dankirkham/HandheldGame/README.md

# HandheldGame
DOT MATRIX WITHOUT STEREO SOUND

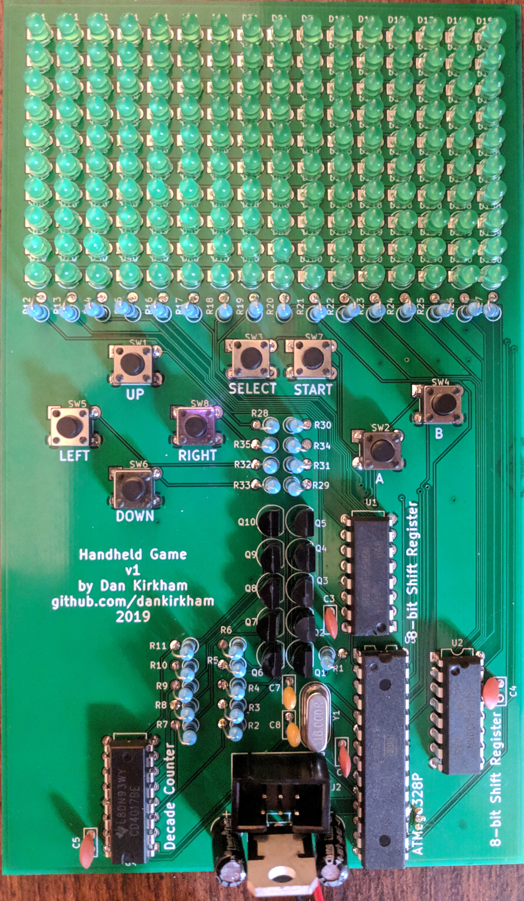
[picture p1: pics/assembly.jpg]
HandheldGame Assembly
