dankirkham/HandheldGame/enclosure/top.stl

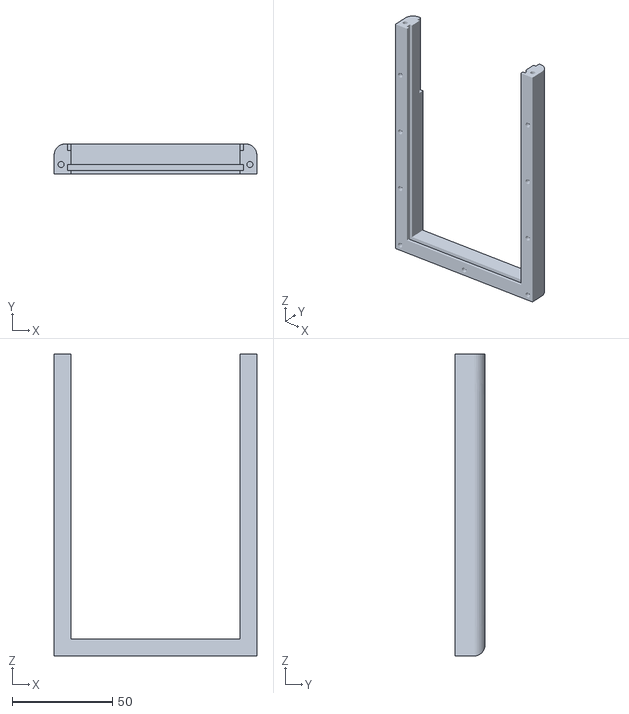
[picture p2: CAD file, 2020-03-05]
enclosure/top.stl
101.1 x 15.0 x 150.6
