dankirkham/HandheldGame/enclosure/bottom.stl

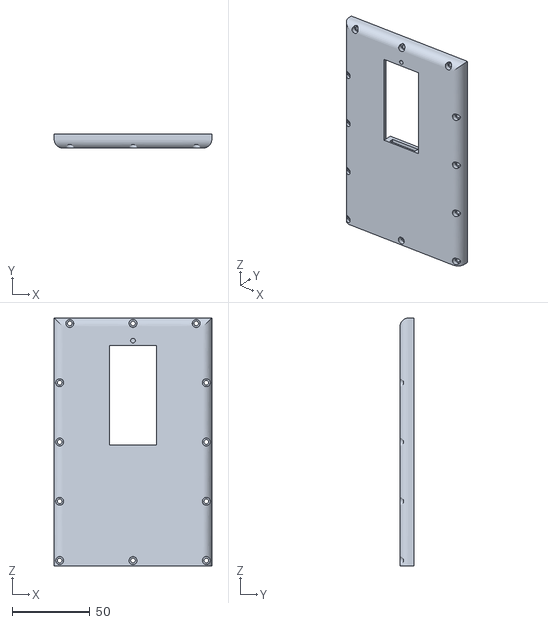
[picture p3: CAD file, 2020-03-05]
enclosure/bottom.stl
101.1 x 9.00 x 159.1
