dankirkham/HandheldGame/enclosure/top_base.stl

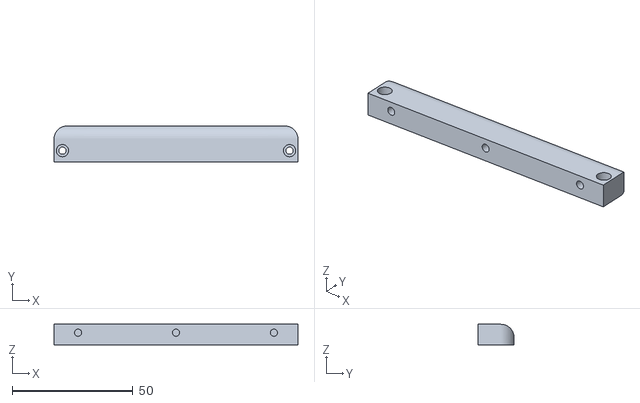
[picture p4: CAD file, 2020-03-05]
enclosure/top_base.stl
101.1 x 15.0 x 8.50
