dankirkham/HandheldGame/enclosure/battery_door.stl

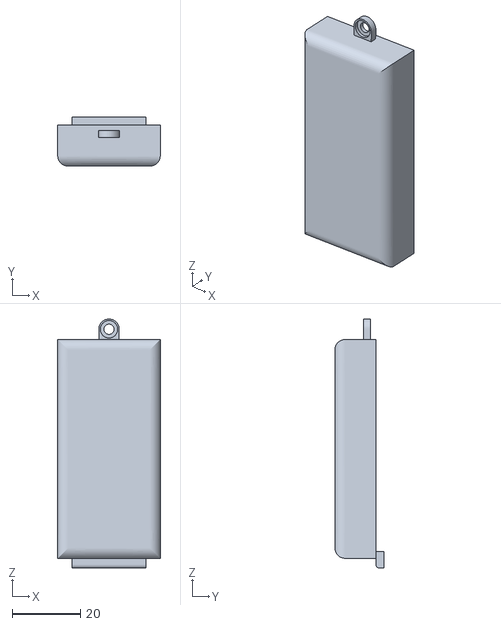
[picture p5: CAD file, 2020-03-05]
enclosure/battery_door.stl
30.0 x 14.4 x 72.8
