dankirkham/HandheldGame/hardware/HandheldGame-v1/outputs/pdf/HandheldGame-schematic.pdf

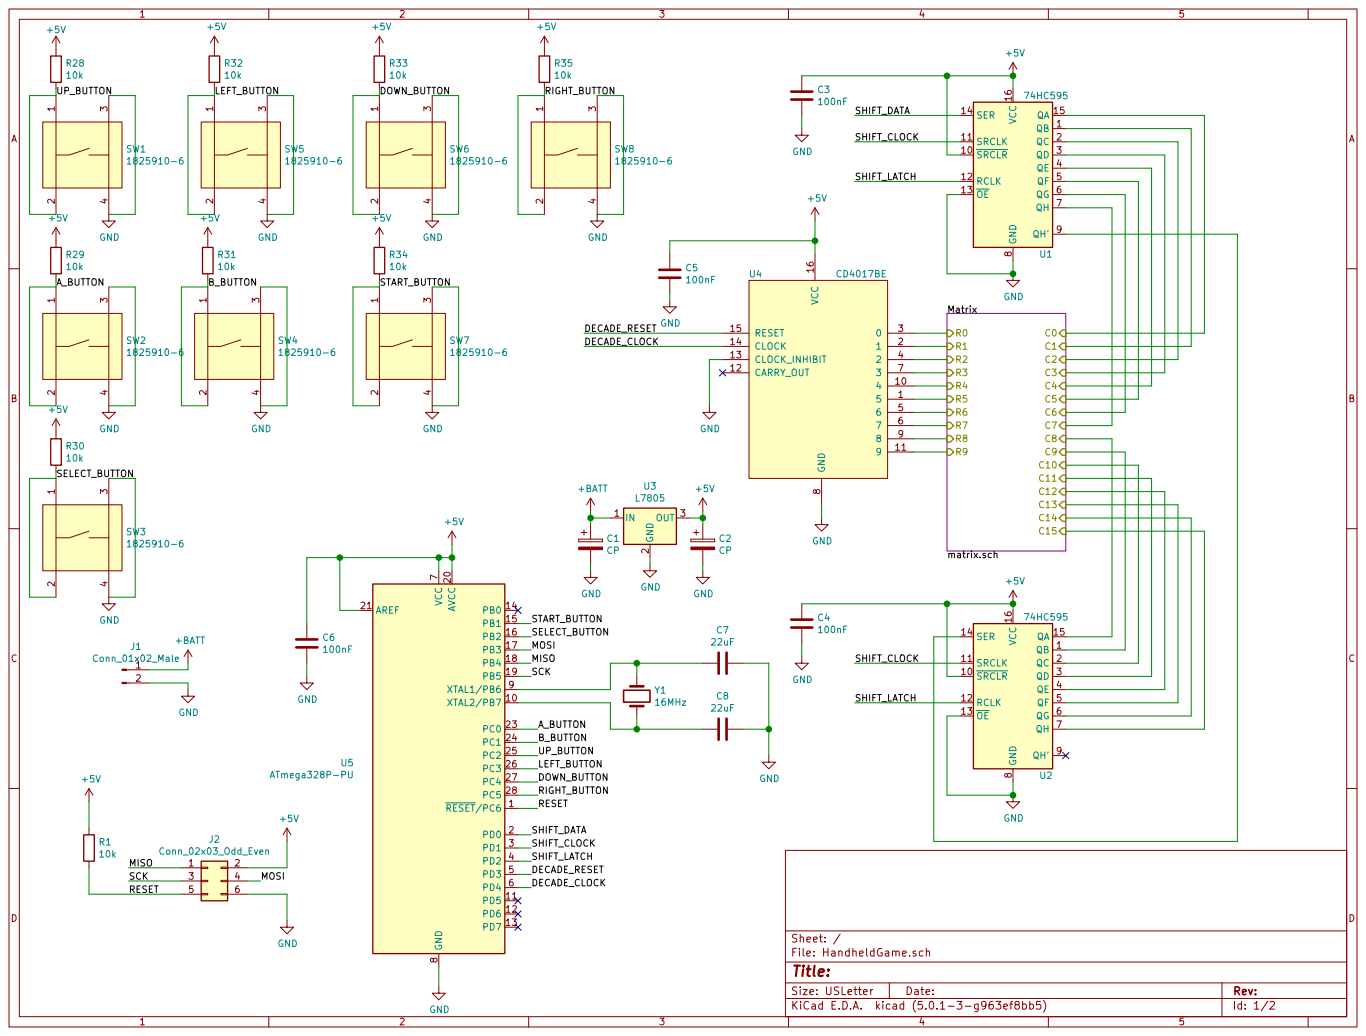
[picture p13: page 1]

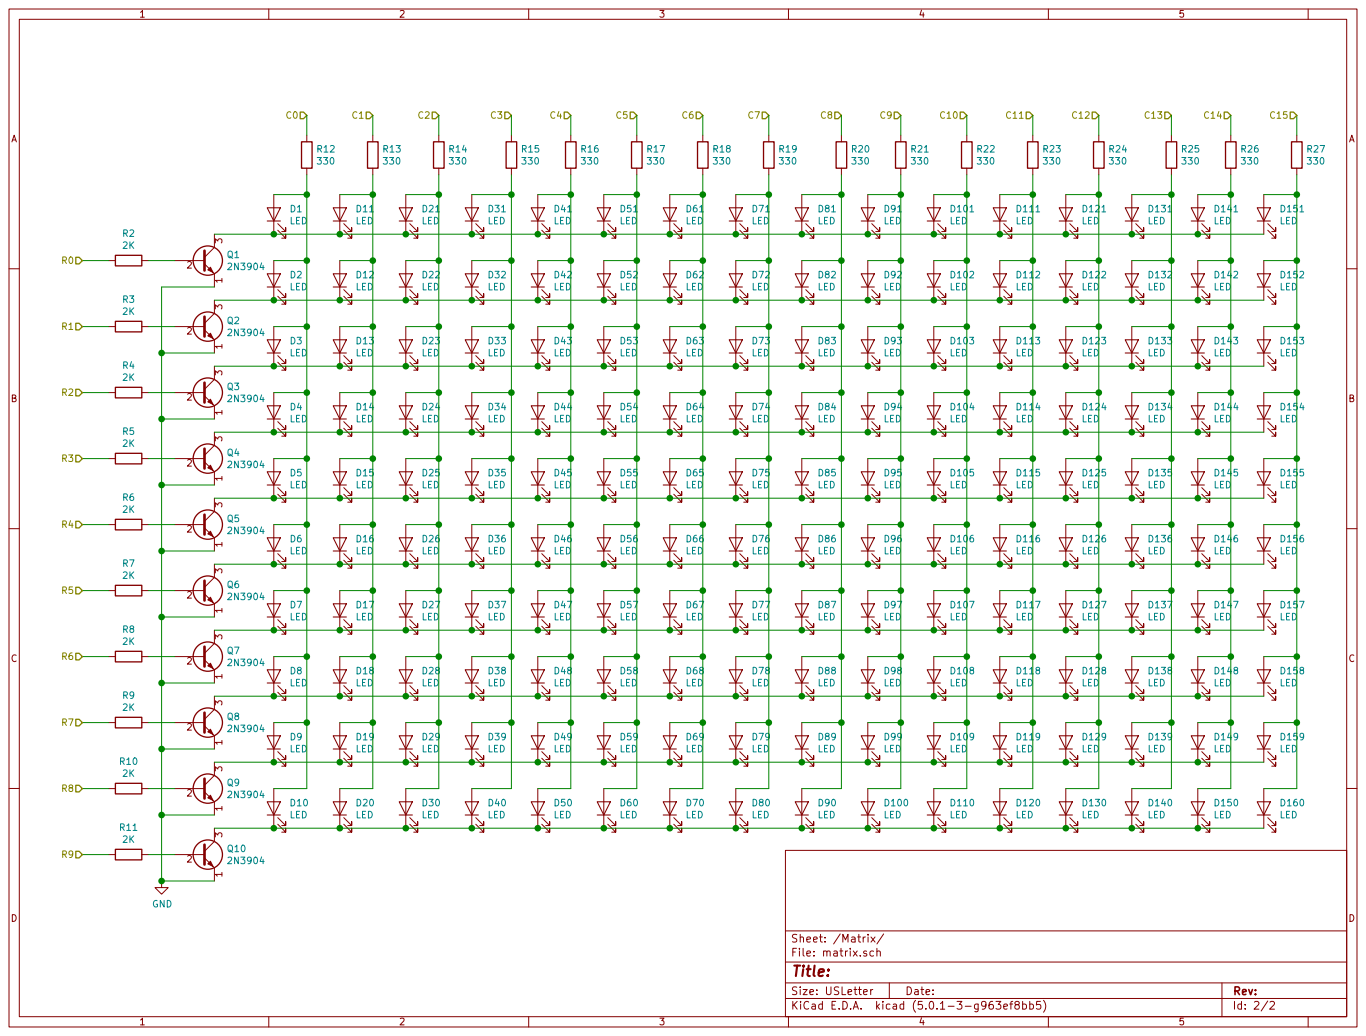
[picture p14: page 2]

Id: 2/2 Title: File: matrix.sch Sheet: /Matrix/
