dankirkham/HandheldGame/hardware/HandheldGame-v1/HandheldGame.kicad_pcb

## KiCad design hardware/HandheldGame-v1/HandheldGame.kicad_pcb (2019-03-29)

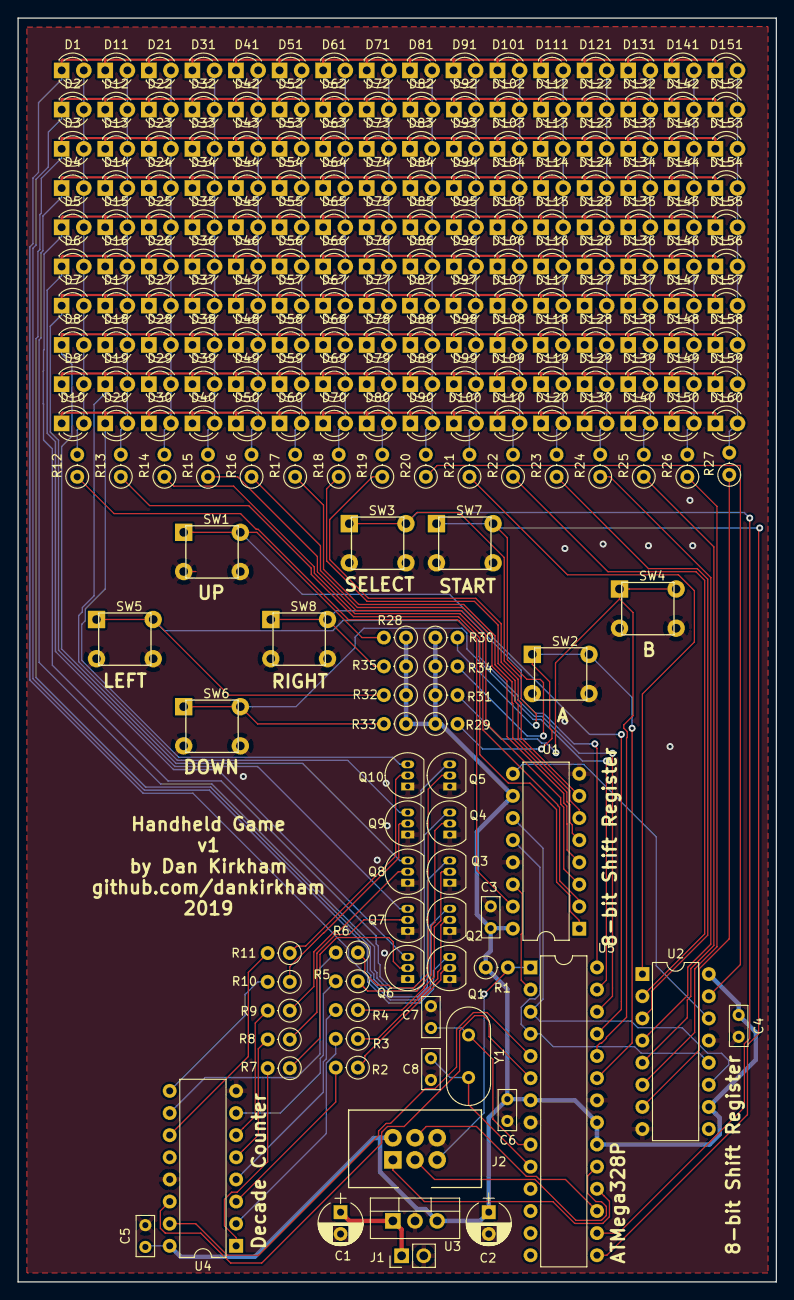
[picture p15: board HandheldGame.kicad_pcb from above]

Board: 2 copper layers, 87.0 x 145.0 mm, 229 parts (0 on the bottom side), 85 nets.

Parts:
C1, C2: CP; CP_Radial_D5.0mm_P2.50mm
C3, C4, C5, C6: 100nF; C_Rect_L4.6mm_W2.0mm_P2.50mm_MKS02_FKP02
C7, C8: 22uF; C_Rect_L4.6mm_W2.0mm_P2.50mm_MKS02_FKP02
D1, D2, D3, D4, D5, D6, D7, D8, D9, D10, D11, D12, D13, D14, D15, D16, D17, D18, D19, D20, D21, D22, D23, D24, D25, D26, D27, D28, D29, D30, D31, D32, D33, D34, D35, D36, D37, D38, D39, D40, D41, D42, D43, D44, D45, D46, D47, D48, D49, D50, D51, D52, D53, D54, D55, D56, D57, D58, D59, D60, D61, D62, D63, D64, D65, D66, D67, D68, D69, D70, D71, D72, D73, D74, D75, D76, D77, D78, D79, D80, D81, D82, D83, D84, D85, D86, D87, D88, D89, D90, D91, D92, D93, D94, D95, D96, D97, D98, D99, D100, D101, D102, D103, D104, D105, D106, D107, D108, D109, D110, D111, D112, D113, D114, D115, D116, D117, D118, D119, D120, D121, D122, D123, D124, D125, D126, D127, D128, D129, D130, D131, D132, D133, D134, D135, D136, D137, D138, D139, D140, D141, D142, D143, D144, D145, D146, D147, D148, D149, D150, D151, D152, D153, D154, D155, D156, D157, D158, D159, D160: LED; LED_D3.0mm
J1: Conn_01x02_Male; Pin_Header_Straight_1x02_Pitch2.54mm
J2: Conn_02x03_Odd_Even; ISP_Header
Q1, Q2, Q3, Q4, Q5, Q6, Q7, Q8, Q9, Q10: 2N3904; TO-92_Inline_Narrow_Oval
R1, R28, R29, R30, R31, R32, R33, R34, R35: 10k; R_Axial_DIN0207_L6.3mm_D2.5mm_P2.54mm_Vertical
R2, R3, R4, R5, R6, R7, R8, R9, R10, R11: 2K; R_Axial_DIN0207_L6.3mm_D2.5mm_P2.54mm_Vertical
R12, R13, R14, R15, R16, R17, R18, R19, R20, R21, R22, R23, R24, R25, R26, R27: 330; R_Axial_DIN0207_L6.3mm_D2.5mm_P2.54mm_Vertical
SW1, SW2, SW3, SW4, SW5, SW6, SW7, SW8: 1825910-6
U1, U2: 74HC595; DIP-16_W7.62mm
U3: L7805; TO-220-3_Vertical
U4: CD4017BE; DIP-16_W7.62mm
U5: ATmega328P-PU; DIP-28_W7.62mm
Y1: 16MHz; Crystal_HC49-U_Vertical

Connections:
+5V: C2.1, C3.1, C4.1, C5.1, C6.1, J2.2, R1.1, R28.1, R29.1, R30.1, R31.1, R32.1, R33.1, R34.1, R35.1, U1.10, U1.16, U2.10, U2.16, U3.3, U4.16, U5.7, U5.20, U5.21
+BATT: C1.1, J1.1, U3.1
/A_BUTTON: R29.2, SW2.1, SW2.2, U5.23
/B_BUTTON: R31.2, SW4.1, SW4.2, U5.24
/DECADE_CLOCK: U4.14, U5.6
/DECADE_RESET: U4.15, U5.5
/DOWN_BUTTON: R33.2, SW6.1, SW6.2, U5.27
/LEFT_BUTTON: R32.2, SW5.1, SW5.2, U5.26
/MISO: J2.1, U5.18
/MOSI: J2.4, U5.17
/Matrix/C0: R12.1, U1.15
/Matrix/C1: R13.1, U1.1
/Matrix/C2: R14.1, U1.2
/Matrix/C3: R15.1, U1.3
/Matrix/C4: R16.1, U1.4
/Matrix/C5: R17.1, U1.5
/Matrix/C6: R18.1, U1.6
/Matrix/C7: R19.1, U1.7
/Matrix/C8: R20.1, U2.15
/Matrix/C9: R21.1, U2.1
/Matrix/C10: R22.1, U2.2
/Matrix/C11: R23.1, U2.3
/Matrix/C12: R24.1, U2.4
/Matrix/C13: R25.1, U2.5
/Matrix/C14: R26.1, U2.6
/Matrix/C15: R27.1, U2.7
/Matrix/R0: R2.2, U4.3
/Matrix/R1: R3.2, U4.2
/Matrix/R2: R4.2, U4.4
/Matrix/R3: R5.2, U4.7
/Matrix/R4: R6.2, U4.10
/Matrix/R5: R7.2, U4.1
/Matrix/R6: R8.2, U4.5
/Matrix/R7: R9.2, U4.6
/Matrix/R8: R10.2, U4.9
/Matrix/R9: R11.2, U4.11
/RESET: J2.5, R1.2, U5.1
/RIGHT_BUTTON: R35.2, SW8.1, SW8.2, U5.28
/SCK: J2.3, U5.19
/SELECT_BUTTON: R30.2, SW3.1, SW3.2, U5.16
/SHIFT_CLOCK: U1.11, U2.11, U5.3
/SHIFT_DATA: U1.14, U5.2
/SHIFT_LATCH: U1.12, U2.12, U5.4
/START_BUTTON: R34.2, SW7.1, SW7.2, U5.15
/UP_BUTTON: R28.2, SW1.1, SW1.2, U5.25
GND: C1.2, C2.2, C3.2, C4.2, C5.2, C6.2, C7.1, C8.1, J1.2, J2.6, Q1.1, Q2.1, Q3.1, Q4.1, Q5.1, Q6.1, Q7.1, Q8.1, Q9.1, Q10.1, SW1.3, SW1.4, SW2.3, SW2.4, SW3.3, SW3.4, SW4.3, SW4.4, SW5.3, SW5.4, SW6.3, SW6.4, SW7.3, SW7.4, SW8.3, SW8.4, U1.8, U1.13, U2.8, U2.13, U3.2, U4.8, U4.13, U5.8, U5.22
unnamed: C7.2, U5.9, Y1.1
unnamed: C8.2, U5.10, Y1.2
unnamed: D1.1, D11.1, D21.1, D31.1, D41.1, D51.1, D61.1, D71.1, D81.1, D91.1, D101.1, D111.1, D121.1, D131.1, D141.1, D151.1, Q1.3
unnamed: D1.2, D2.2, D3.2, D4.2, D5.2, D6.2, D7.2, D8.2, D9.2, D10.2, R12.2
unnamed: D10.1, D20.1, D30.1, D40.1, D50.1, D60.1, D70.1, D80.1, D90.1, D100.1, D110.1, D120.1, D130.1, D140.1, D150.1, D160.1, Q10.3
unnamed: D11.2, D12.2, D13.2, D14.2, D15.2, D16.2, D17.2, D18.2, D19.2, D20.2, R13.2
unnamed: D21.2, D22.2, D23.2, D24.2, D25.2, D26.2, D27.2, D28.2, D29.2, D30.2, R14.2
unnamed: D31.2, D32.2, D33.2, D34.2, D35.2, D36.2, D37.2, D38.2, D39.2, D40.2, R15.2
unnamed: D41.2, D42.2, D43.2, D44.2, D45.2, D46.2, D47.2, D48.2, D49.2, D50.2, R16.2
unnamed: D51.2, D52.2, D53.2, D54.2, D55.2, D56.2, D57.2, D58.2, D59.2, D60.2, R17.2
unnamed: D61.2, D62.2, D63.2, D64.2, D65.2, D66.2, D67.2, D68.2, D69.2, D70.2, R18.2
unnamed: D71.2, D72.2, D73.2, D74.2, D75.2, D76.2, D77.2, D78.2, D79.2, D80.2, R19.2
unnamed: D81.2, D82.2, D83.2, D84.2, D85.2, D86.2, D87.2, D88.2, D89.2, D90.2, R20.2
unnamed: D91.2, D92.2, D93.2, D94.2, D95.2, D96.2, D97.2, D98.2, D99.2, D100.2, R21.2
unnamed: D101.2, D102.2, D103.2, D104.2, D105.2, D106.2, D107.2, D108.2, D109.2, D110.2, R22.2
unnamed: D2.1, D12.1, D22.1, D32.1, D42.1, D52.1, D62.1, D72.1, D82.1, D92.1, D102.1, D112.1, D122.1, D132.1, D142.1, D152.1, Q2.3
unnamed: D3.1, D13.1, D23.1, D33.1, D43.1, D53.1, D63.1, D73.1, D83.1, D93.1, D103.1, D113.1, D123.1, D133.1, D143.1, D153.1, Q3.3
unnamed: D4.1, D14.1, D24.1, D34.1, D44.1, D54.1, D64.1, D74.1, D84.1, D94.1, D104.1, D114.1, D124.1, D134.1, D144.1, D154.1, Q4.3
unnamed: D5.1, D15.1, D25.1, D35.1, D45.1, D55.1, D65.1, D75.1, D85.1, D95.1, D105.1, D115.1, D125.1, D135.1, D145.1, D155.1, Q5.3
unnamed: D6.1, D16.1, D26.1, D36.1, D46.1, D56.1, D66.1, D76.1, D86.1, D96.1, D106.1, D116.1, D126.1, D136.1, D146.1, D156.1, Q6.3
unnamed: D7.1, D17.1, D27.1, D37.1, D47.1, D57.1, D67.1, D77.1, D87.1, D97.1, D107.1, D117.1, D127.1, D137.1, D147.1, D157.1, Q7.3
unnamed: D8.1, D18.1, D28.1, D38.1, D48.1, D58.1, D68.1, D78.1, D88.1, D98.1, D108.1, D118.1, D128.1, D138.1, D148.1, D158.1, Q8.3
unnamed: D9.1, D19.1, D29.1, D39.1, D49.1, D59.1, D69.1, D79.1, D89.1, D99.1, D109.1, D119.1, D129.1, D139.1, D149.1, D159.1, Q9.3
unnamed: D111.2, D112.2, D113.2, D114.2, D115.2, D116.2, D117.2, D118.2, D119.2, D120.2, R23.2
unnamed: D121.2, D122.2, D123.2, D124.2, D125.2, D126.2, D127.2, D128.2, D129.2, D130.2, R24.2
unnamed: D131.2, D132.2, D133.2, D134.2, D135.2, D136.2, D137.2, D138.2, D139.2, D140.2, R25.2
unnamed: D141.2, D142.2, D143.2, D144.2, D145.2, D146.2, D147.2, D148.2, D149.2, D150.2, R26.2
unnamed: D151.2, D152.2, D153.2, D154.2, D155.2, D156.2, D157.2, D158.2, D159.2, D160.2, R27.2
unnamed: Q1.2, R2.1
unnamed: Q2.2, R3.1
unnamed: Q3.2, R4.1
unnamed: Q4.2, R5.1
unnamed: Q5.2, R6.1
unnamed: Q6.2, R7.1
unnamed: Q7.2, R8.1
unnamed: Q8.2, R9.1
unnamed: Q9.2, R10.1
unnamed: Q10.2, R11.1
unnamed: U1.9, U2.14
