dankirkham/HandheldGame/(commit log)

2019-03-29 Initial commit of hardware and Arduino sketch.
    [HandheldGame-B.Cu.gbr, HandheldGame-B.Mask.gbr, HandheldGame-B.Paste.gbr, HandheldGame-B.SilkS.gbr, HandheldGame-Edge.Cuts.gbr, HandheldGame-F.Cu.gbr, HandheldGame-F.Mask.gbr, HandheldGame-F.Paste.gbr]
2020-02-29 Game over on body collision. Dont spawn appled on snek.
    [Snek.cpp]
2020-02-29 Improved button detection/debouncing
2020-03-04 Added an enclosure.
    [battery_door.stl, bottom.stl, top.stl, top_base.stl]
2020-03-05 Enclosure v2.
    [battery_door.stl, bottom.stl, top.stl, top_base.stl]
2021-12-04 Builds for Arduino and x86 targets.
2021-12-09 First cut at QT
2021-12-30 Fix food spawning in snake.
    [Snek.cpp]
2022-03-26 Experiment with shaded colors. Tighten up screen drawing code.
    [ArduinoScreen.cpp, ArduinoScreen.h, Birb.cpp, Brick.cpp, Counter.cpp, MainWindow.cpp, Screen.cpp]
2022-03-27 Add Tetris. Improve button api.
2022-03-29 Optimize several const arrays to use PROGMEM on the arduino, so that they are placed in flash instead of RAM.
2022-03-31 Gui and arduino now use a common executor
2022-04-03 Fix scroll bar on Menu. Add tetris contants to namespace. Add Quest game.
    [Executor.cpp, Executor.h, Menu.cpp, Menu.h, Quest.cpp, Quest.h, Tetris.h]
2022-04-05 Fix entities on real hardware.
    [Input.h, Quest.cpp, Quest.h]
